MrAss0115/bottle-sorter/mechanical/README_原模型说明.md

> 仓库整理说明：原文中的 exports/STL_PROVISIONAL/ 已无损打包为 exports/STL_PROVISIONAL.zip，解压后目录结构不变；原模型源文件未修改。

# 瓶罐分拣机 R0.1：可调尺寸结构模型

本版用于确认结构、调整尺寸、讨论分块和局部试打印。它不是已经通过实物验证的整机加工定稿。

## 先打开什么

- `模型说明与检查结果.html`：整机、上层六格、剖面、滚轮细节、参数和检查结果。
- `exports/BottleSorter_R01_PARAMETRIC.f3d`：Fusion 原生模型。保留用户参数、草图和建模历史。
- `exports/BottleSorter_R01_ASSEMBLY.step`：通用实体装配文件，给打印店查看结构、测量和报价。STEP 不包含原始参数关系与完整建模历史。
- `exports/STL_PROVISIONAL/`：每个候选打印实体单独一个 STL，单位为 mm。文件已平移到原点与底面，但尚未为每个零件选择最终打印方向。
- `exports/parts_list.csv`：文件名、装配分组、实体体积和包围尺寸。
- `exports/parameters.csv`：参数值及已知／暂定／派生状态。
- `qa/geometry_checks.json`：几何检查的原始结果。请与说明页一起看，不能仅凭文件存在判断检查通过。

请先用 F3D 查看和调整。STL 是三角网格，适合切片，不适合作为继续改机械尺寸的主文件。

清单中的体积是 CAD 实体体积，不是实际切片耗材或重量。材料、壁数、填充与支撑都会影响实际旋转负载。独立滚轮明确了承重路径，但现有电机的转矩裕量、加减速和换桶时间仍需结合实测电机及带载试验确定。

## 我按什么结构建模

1. 上层送料底板与围壁固定，六片径向挡板作为一套旋转组件。
2. 送料内径为 600 mm；它不包括壁厚、顶部轨道、支架和机架。
3. 底板外高内低，坡度参数为 `slope`，首版暂取 2°，可以改成 0°比较。
4. 挡板下缘随底板坡度变化，上缘保持水平。底部与围壁处均有运行间隙。
5. 固定底板开一个局部圆角落料口，位置在 +X 方向。开口不切断围壁顶部轨道。
6. 第 1、3、5 片挡板配倒 U 形跨壁支架。轴承轴线水平、沿半径方向，轴承竖放，外圈下缘接触水平轨道。
7. 下层三个桶装在共同托盘上，作为一套机构旋转。每只桶可取出；桶底定位结构跟随托盘转动。
8. 托盘由独立滚轮支承，第二台电机负责驱动。载荷能力仍需按真实零件及收集物验证。

模型分组：`00_FIXED_FRAME` 固定机架；`10_FIXED_FEED_DECK` 固定上层；`20_ROTATING_SIX_BLADES` 旋转挡板；`30_ROTATING_THREE_BINS` 旋转托盘和桶；`40_HARDWARE_PLACEHOLDERS` 现有电机与拟用标准件；`50_SENSOR_AND_CAMERA_RESERVATIONS` 传感器及空间预留。隐藏的 `90_` 分组是开孔工具和参考几何，不是实物零件。

轴承、轴、隔套在 CAD 中是简化包络。实际固定时应夹紧轴承内圈，外圈必须自由转动；隔套尺寸要以实际轴承为准。

轴用螺栓实体只用于表示轴线与穿孔位置，未完整绘制头部、螺母和垫片。采购长度必须计入实际夹持长度、锁紧件堆叠、露出的螺纹及工具空间，不能直接照包络实体长度购买。

## 怎样改尺寸

在 Fusion 的“修改 → 更改参数”中找到命名参数。建议先另存一个版本，每次只改一组相关尺寸，更新后重新检查。

- `feed_ID`：围壁内径。
- `slope`：底板坡度，0°为平底。
- `deck_Z`、`wall_H`、`blade_H`：底板高度、轨道高度与挡板高度关系。
- `floor_gap`、`wall_gap`：竖直／径向运行间隙，均为试验值。
- `drop_X`、`drop_L`、`drop_W`、`drop_R`：固定开口位置、长宽和圆角。
- `hole_edge_R`：落料孔板厚方向的倒圆半径。实际成功的特征及失败项记录在 `qa/drop_edge_rounding.json`；平面四角圆角与板厚边缘倒圆是两件事。
- `tray_R`、`bin_Ri`、`bin_Ro`、`bin_H`：托盘与桶的尺寸。
- `roller_OD`、`roller_ID`、`roller_W`：轴承包络尺寸。
- `shaft_D`、`motor_W`、`motor_L`、`motor_pitch`：尚未实测的电机接口占位值。
- `upper_angle`、`lower_angle`：装配姿态参数。它们表示名义几何姿态，不代表电机已经实测到位，也不是控制程序。

上、下层姿态由各旋转零件末端的 `RigidUpperPose`／`RigidLowerPose` 原生旋转特征驱动。草图支承平面保留在建模姿态，避免跨角度修改时出现上下翻转。不要把这些特征的角度公式改成常数；修改上面的用户姿态参数即可。

有些尺寸由公式决定，例如滚轮中心高度 `axle_Z = track_Z + roller_OD/2`。这使滚轮底部随轨道和直径参数保持正确高度。

尺寸修改不是无限制的：例如桶变大后要重新检查机架间隙，开口变大后要重新检查相邻格提前落料。打印机尺寸参数用于提醒与检查，不会自动重新选择分块拓扑。

## 哪些还没有定稿

- 两台电机的真实型号、轴形、轴径、轴伸、安装孔与转矩曲线还没有在本次测量。当前 42 mm 电机、5 mm 轴等值是明确标注的占位值。
- `shaft_flat` 是为 D 轴预留的参数，本版没有凭猜测切出 D 形轴孔。必须实测后匹配，或保留原金属法兰。
- 打印夹紧轮毂需要实物夹紧与打滑试验，不能据模型外形认定能传递足够转矩。
- 轮毂上的挡板插槽用于结构研究。挡板内侧孔尚不构成完整的轮毂锁紧连接；挡板的径向防脱、轴向保持，以及上部标记环的紧固仍需完善，不能把接触面当成已经装牢。
- 轨道已设下方定位拼接示例；底板、桶壁、机架等所有接缝的最终螺钉、螺母、加强件与拆装细节仍需下一轮定型。不能把相接表面直接当作已完成紧固设计。
- 槽型光电／霍尔传感器型号未定。模型提供分开的原点与工位轨道、安装空间和可替换安装板；实际传感器、槽宽、触发距离与线缆固定仍需匹配。
- 相机和照明保留空间，观察工位尚未最终确定。
- 物品直径、重量和形状未实测。说明中的 200 × 75 mm 包络仅用于明确标注的几何例子，75 mm 不是已确认的最大瓶径。
- 没有完成材料强度、蠕变、打印翘曲、摩擦、真实瓶子滚动／挤压、驱动转矩或物理仿真。

## 为什么仍要做瓶子试验

空转正常、放瓶后卡顿，说明要重点检查瓶子与壁面、接缝、挡板间的作用。增加刚度、降低阻力、处理夹口、避免联轴器打滑，以及合理的加减速都可能相关，不能只靠更换打印材料解决。

浅坡只是可比较的试验方案。它可能减轻向外挤压，也可能把物品推向中心。圆角开口也不保证所有歪斜姿态都能通过；具体几何例子见检查页。

等待识别与下层换桶时，物品应停在与开口有足够距离的完整底板区域。首版建议单件流程并在局部试验中检查等待位置；不把“某次没有掉下去”当作可靠挡料。

## 装配与局部试验顺序

1. **轨道接缝与滚轮支架。** 先试相邻两段轨道、下方拼接件、一个 U 支架和真实轴承。目的：确认装配后顶面没有可感知的台阶，支架两侧不蹭壁，外圈可连续滚动。若出现周期性爬坡、卡住或支架擦痕，先处理接缝与高度，不增加电机硬推。
2. **轮毂接口。** 用实测轴尺寸更新后再打印试件，并在轴与轮毂上做对齐标记。目的：分辨电机失步与连接件打滑。若标记相对移动或打印件开裂，该连接不能直接投入整机。
3. **单格推瓶与落瓶。** 用实际空瓶、空罐，比较平底／浅坡、正放／歪斜、瓶口朝内／朝外。成功标准包括连续通过、没有挂边、等待时不会提前失去支承。一次通过不能证明可靠性。
4. **下层独立支承。** 先空托盘、再三个空桶，最后逐步加入已称重载荷。确认桶不滑移、不碰机架，传动没有滑动，再验证低速启动、停止和传感器到位。
5. **联动。** 下层传感器确认目标桶到位后，上层才放行；落瓶通道清空前，下层不能换桶。找不到标记或出现卡瓶时停止，不连续补步硬推。

上层轮毂与三个滚轮必须协调高度：应让三个轮正常接触轨道，同时避免中心连接把挡板吊起或强压轨道。实际调整方案仍需结合电机接口与标准件定型。

## 控制程序边界

本交付是机械 CAD。此前 V2 下层 −30°／0°／+30° 的角度不能直接用于这个 120° 三桶托盘。自动回零、工位确认和落瓶确认需要相应传感器与程序修改；原点和工位标记应跟随实际转动组件。

## 标准件候选清单

以下用于核对结构和询价，不应在电机／轴承／传感器实测前整批采购：

| 标准件 | 名义数量 | 说明 |
|---|---:|---|
| 现有步进电机及驱动器 | 2 套 | 保留；型号、安装尺寸、速度与负载能力待核对 |
| 滚轮轴承包络 | 9 个 | 上层 3、下层 6；本版暂按 22 × 8 × 7 mm 包络 |
| M8 轴用螺栓／螺母／垫片 | 9 套 | 螺栓长度按实际支架、隔套和锁紧件堆叠选择 |
| 轴承内圈隔套 | 18 个 | 上层 6、下层 12；外径不能压住外圈 |
| 上层支架与挡板 M4 紧固件 | 3 套 | 图中有对应孔位，装配间隙要以试件验证 |
| 夹紧轮毂 M4 紧固件 | 1 套起 | 孔位是试验设计；接口尺寸未确认 |
| 轨道拼接 M3 螺钉与热熔铜螺母 | 24 套 | 铜螺母孔径／长度为暂定参数，先用真实标准件做接缝试件 |
| 电机安装紧固件 | 按实测孔位 | 不根据占位孔径直接采购 |
| 原点与工位传感器 | 型号待定 | 上下层原点和普通工位分开检测轨道；可评估共用多通道安装板 |
| 落瓶对射传感器 | 1 套候选 | 与转盘到位检测分开 |

机架、底板、桶体等最终连接件不在上述定量清单中，因为其接缝紧固设计尚未完成。

## 源文件

`source/` 保存建模、装配细化、导出和检查程序，`source/BottleSorterR01/` 是 Fusion 脚本入口。重新运行会生成一个新文档，适合复现首版；日常改尺寸优先使用已经生成的 F3D 用户参数。中间进度、日志和检查数据在 `qa/`，不需要交给打印店作为打印零件。
