MrAss0115/bottle-sorter/THIRD_PARTY_NOTICES.md

# Third-party notices

`dependencies/ei-dajimk-project-1-arduino-1.0.5.zip` is the supplied Edge Impulse Arduino export, library DajimK-project-1_inferencing version 1.0.5. It retains bundled notices and licenses, including `src/edge-impulse-sdk/LICENSE`. Model labels are AluCan, Other and PetBottle. The archive is included unchanged; the generated library is not presented as original project code.

Arduino cores, ESP32 camera/Wi-Fi libraries, Adafruit GFX and Adafruit SSD1306 retain their respective upstream licenses and are installed separately. No license for all team-authored project materials has been selected by this initial organization step.
