MrAss0115/bottle-sorter/mechanical/images/07_full_side.png

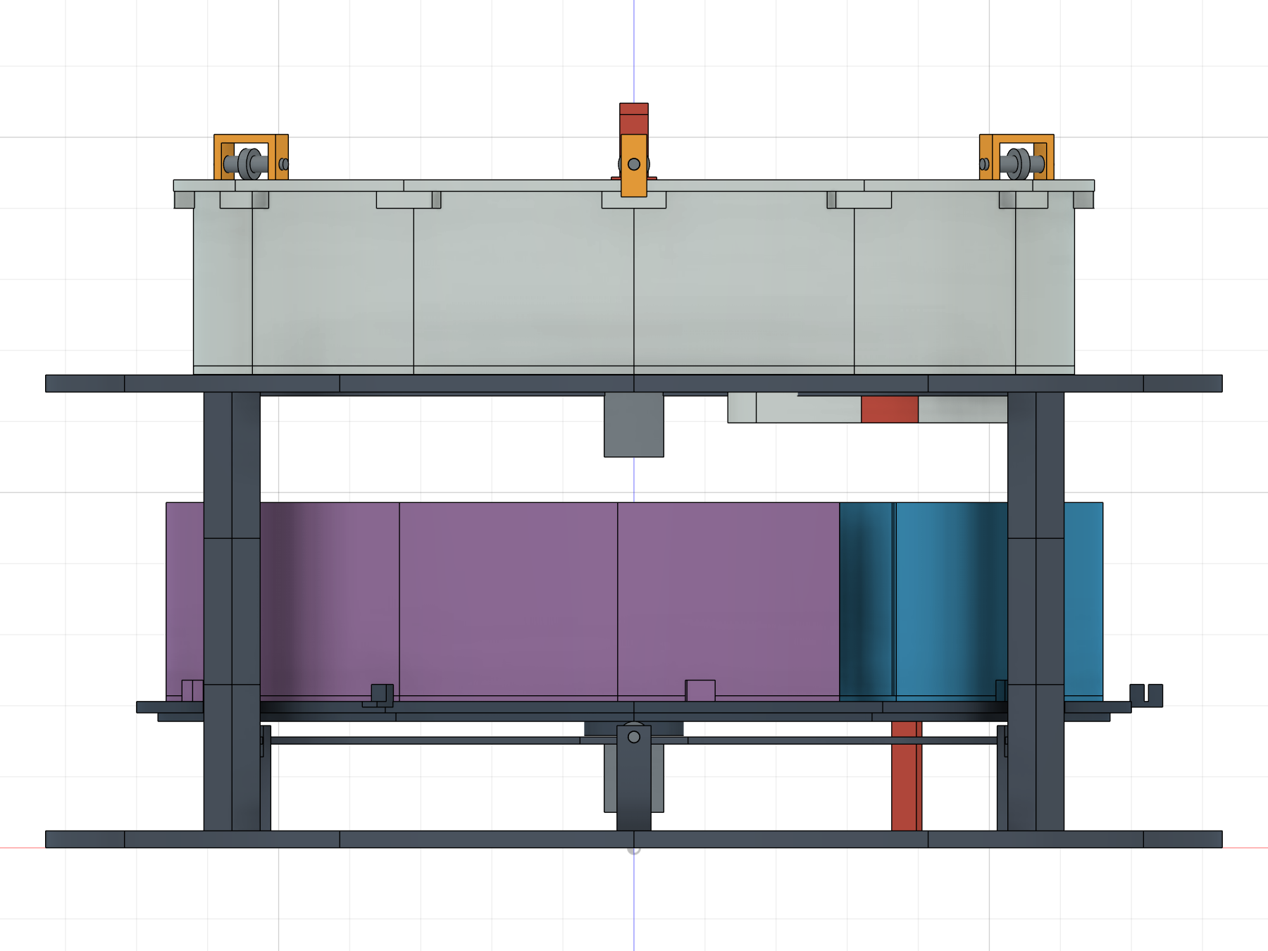
mechanical/images/07_full_side.png
