MrAss0115/bottle-sorter/mechanical/exports/BottleSorter_R01_ASSEMBLY.step

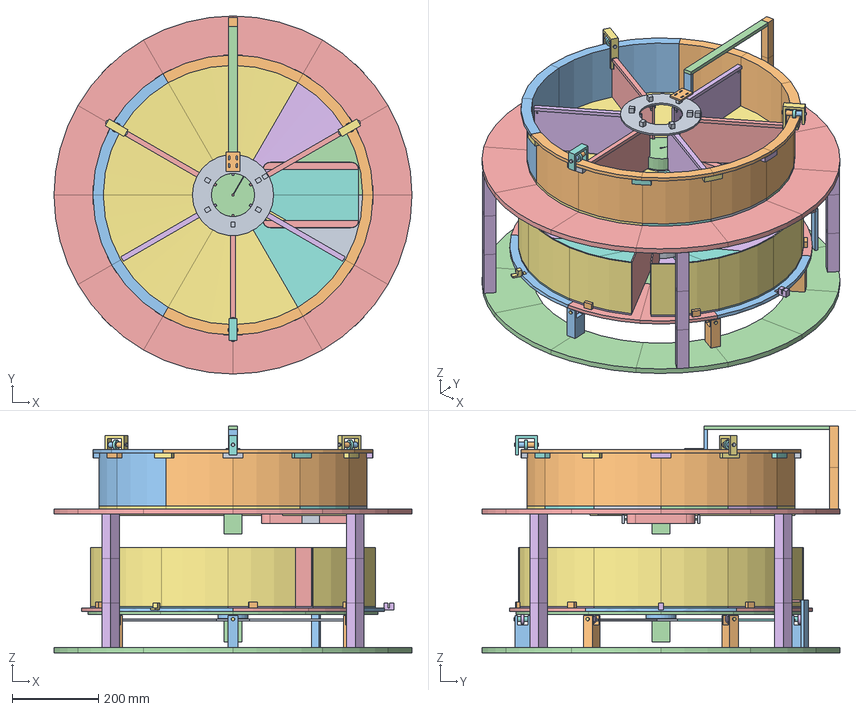
[picture p9: CAD file, 2026-11-04]
mechanical/exports/BottleSorter_R01_ASSEMBLY.step
828.0 x 828.0 x 524.0 mm
