MrAss0115/bottle-sorter/mechanical/exports/FIRST_TEST_PRINT/WALL_TRACK_01.stl

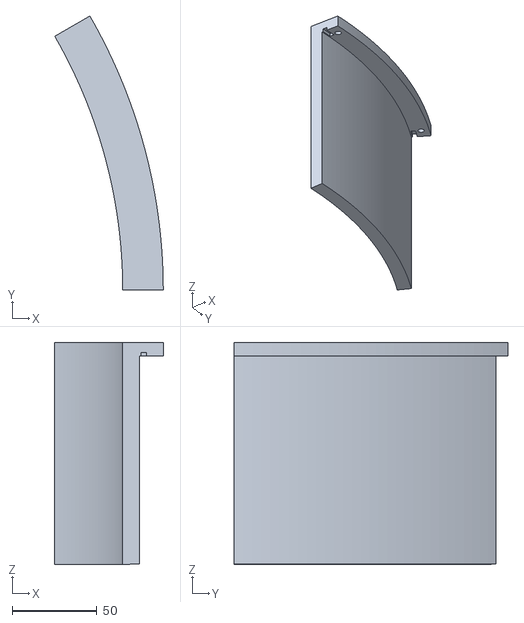
[picture p10: CAD file, 2026-11-04]
mechanical/exports/FIRST_TEST_PRINT/WALL_TRACK_01.stl
64.2 x 162.0 x 131.3
