MrAss0115/bottle-sorter/mechanical/exports/FIRST_TEST_PRINT/U_BRACKET_1.stl

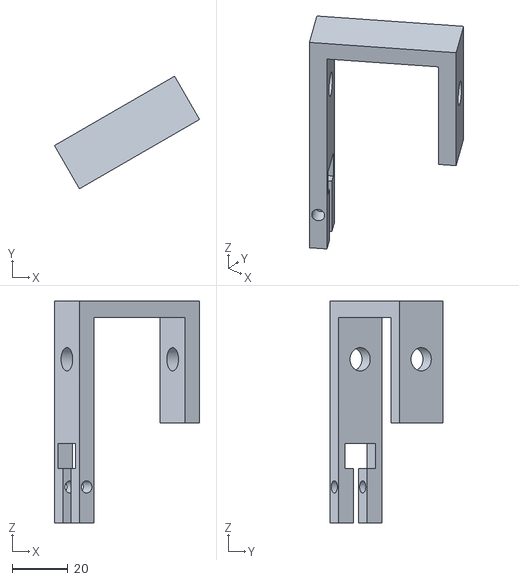
[picture p11: CAD file, 2026-11-04]
mechanical/exports/FIRST_TEST_PRINT/U_BRACKET_1.stl
52.3 x 40.6 x 80.0
