MrAss0115/bottle-sorter/mechanical/exports/FIRST_TEST_PRINT/TRACK_UNDERSIDE_SPLICE_01.stl

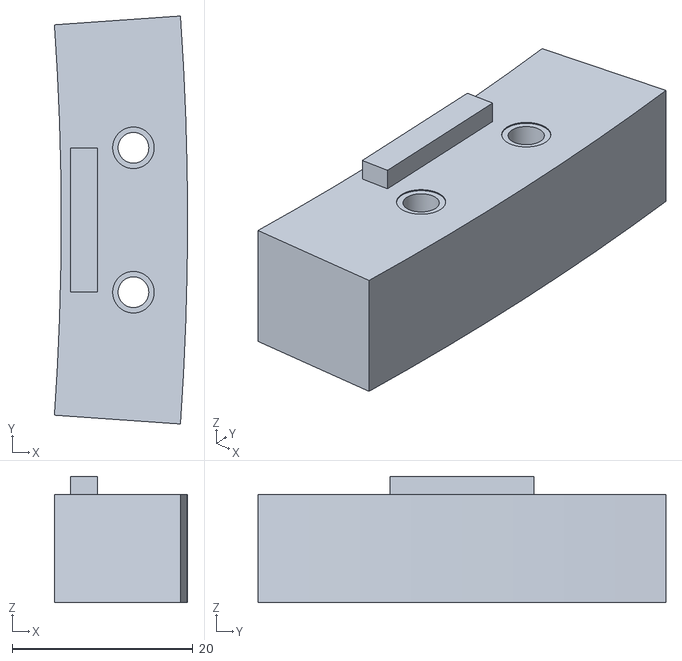
[picture p12: CAD file, 2026-11-04]
mechanical/exports/FIRST_TEST_PRINT/TRACK_UNDERSIDE_SPLICE_01.stl
14.8 x 45.2 x 14.0
