MrAss0115/bottle-sorter/(list of files, cad)

Other CAD files:
mechanical/exports/FIRST_TEST_PRINT/WALL_TRACK_12.stl
mechanical/source/BottleSorter_R01_PARAMETRIC.f3d
