MrAss0115/bottle-sorter/docs/validation.md

# Validation record 2026-11-04

Repository-relative host checks: 23/23 passed (11 legacy chute and 12 manual-result demo scenarios), using g++ with C++11, Wall, Wextra and Werror. The imported motor-control logic is unchanged; text line endings are normalized and test include paths were updated for the new folder layout.

The ESP32 hotspot password was extracted into an ignored local header and an example was provided. The ESP32 sketch was not compiled or uploaded as part of this repository import.

The Edge Impulse archive was copied unchanged. All 190 provisional STL members were packed losslessly; member contents were compared byte-for-byte before removing only the generated unpacked repository copies. Original CAD deliverables remain unchanged.

These checks do not measure actual motor arrival, loaded tray performance, drop success, sensor operation, AI accuracy, or the new three-bin control sequence. See known-issues.md and three-bin-migration.md.
