MrAss0115/bottle-sorter/CHANGELOG.md

# Changelog

## Repository baseline 2026-11-04

- Organize legacy Mega real-AI control, manual-result demo, and ESP32 camera code.
- Import Fusion R0.1 three-bin tray model, STEP, provisional STL, images, parameters, parts list, and model report.
- Document the incompatibility between old chute angles and the new common tray.
- Move the ESP32 hotspot password into an ignored local configuration file.
- Retain host checks with repository-relative include paths.
- New tray control and sensor integration remain in progress.
