MrAss0115/bottle-sorter/(commit log)

2026-11-04 Organize legacy motor demos, ESP32 vision and three-bin tray CAD baseline
    Document hardware compatibility, UART setup and owner-reviewed contributions. Retain 23 passing host scenarios and keep new tray control in progress.
    [BottleSorter_R01_ASSEMBLY.step, BottleSorter_R01_PARAMETRIC.f3d, TRACK_UNDERSIDE_SPLICE_01.stl, U_BRACKET_1.stl, WALL_TRACK_01.stl, WALL_TRACK_12.stl, bom.csv, parameters.csv]
2026-11-04 Normalize text line endings and confirm development branch
    [bom.csv, parameters.csv, parts_list.csv]
